artc-asr/artc_ranger_xarm6/ranger_xarm6_description/meshes/big_plant.stl

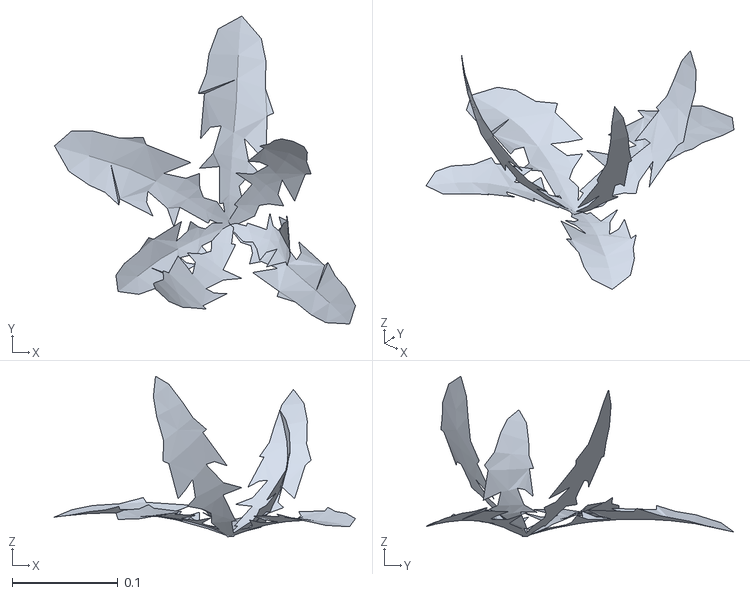
[picture p8: CAD file, 2026-09-24]
ranger_xarm6_description/meshes/big_plant.stl
0.285 x 0.291 x 0.152
