artc-asr/artc_ranger_xarm6/ranger_xarm6_description/meshes/collision/extras_compressed/extras_compressed_48.stl

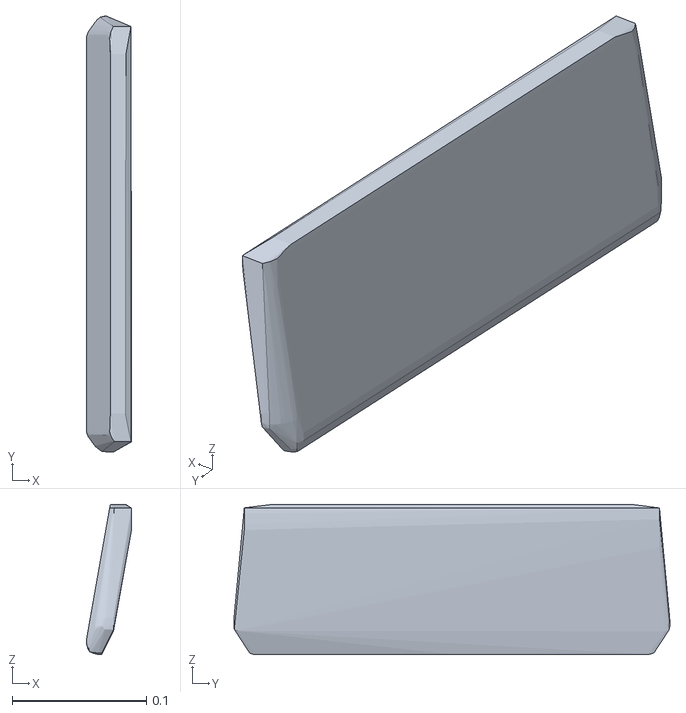
[picture p9: CAD file, 2026-09-24]
ranger_xarm6_description/meshes/collision/extras_compressed/extras_compressed_48.stl
0.0338 x 0.324 x 0.112
