artc-asr/artc_ranger_xarm6/ranger_xarm6_description/meshes/collision/hipnuc_imu/hipnuc_imu_07.stl

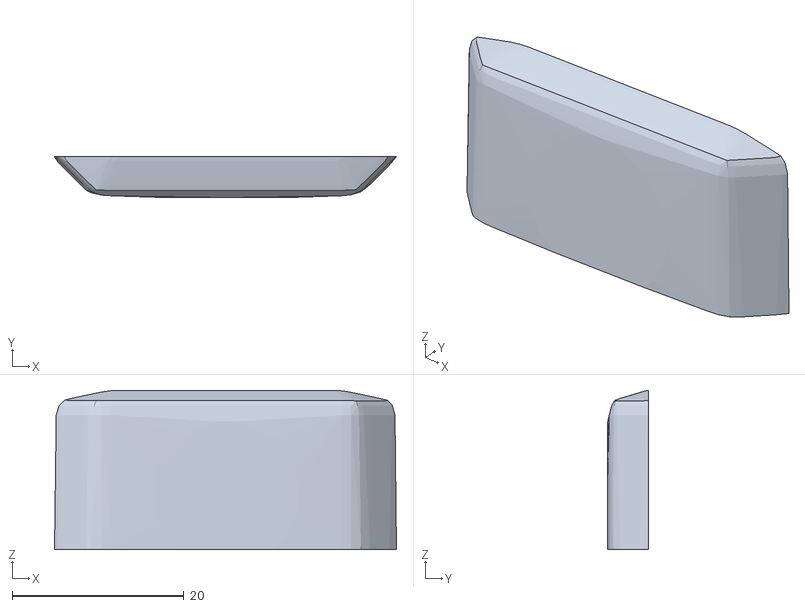
[picture p10: CAD file, 2026-09-24]
ranger_xarm6_description/meshes/collision/hipnuc_imu/hipnuc_imu_07.stl
39.9 x 4.73 x 18.6
