artc-asr/artc_ranger_xarm6/ranger_xarm6_description/meshes/collision/livox_imu_mount/livox_imu_mount_03.stl

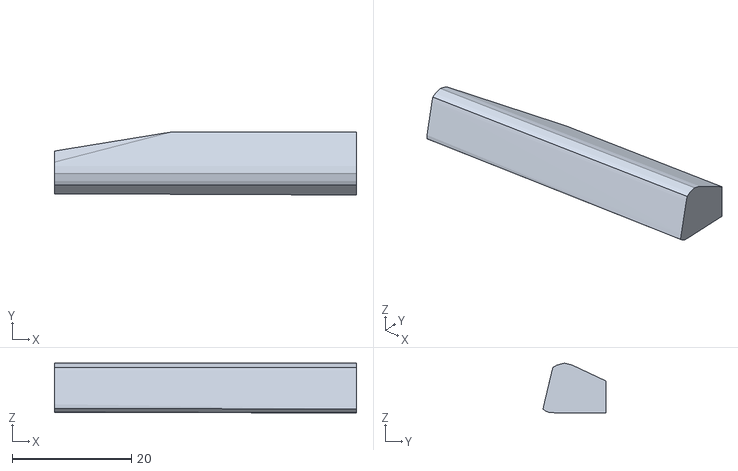
[picture p11: CAD file, 2026-09-24]
ranger_xarm6_description/meshes/collision/livox_imu_mount/livox_imu_mount_03.stl
50.7 x 10.6 x 8.35
