artc-asr/artc_ranger_xarm6/ranger_xarm6_description/meshes/collision/livox_mid_360/livox_mid_360_03.stl

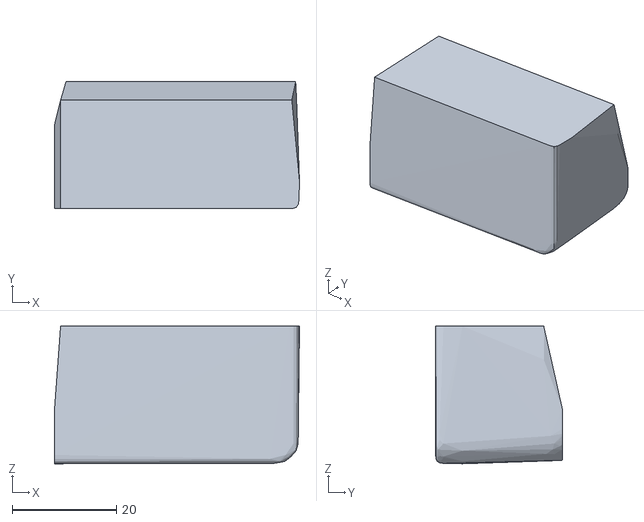
[picture p12: CAD file, 2026-09-24]
ranger_xarm6_description/meshes/collision/livox_mid_360/livox_mid_360_03.stl
47.0 x 24.3 x 26.4
