artc-asr/artc_ranger_xarm6/ranger_xarm6_description/meshes/collision/xarm_mount_plate/xarm_mount_plate_02.stl

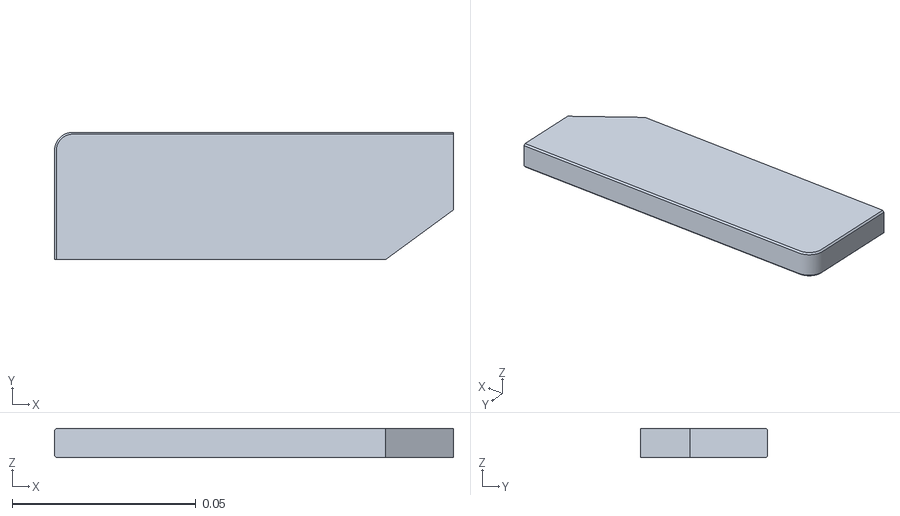
[picture p13: CAD file, 2026-09-24]
ranger_xarm6_description/meshes/collision/xarm_mount_plate/xarm_mount_plate_02.stl
0.109 x 0.0347 x 0.008
