artc-asr/artc_ranger_xarm6/ranger_xarm6_description/meshes/collision/extras_compressed/extras_compressed_25.stl

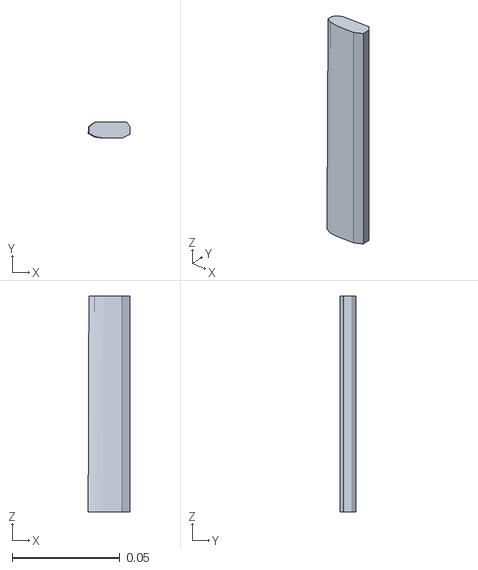
[picture p15: CAD file, 2026-09-24]
ranger_xarm6_description/meshes/collision/extras_compressed/extras_compressed_25.stl
0.0194 x 0.00761 x 0.1
