artc-asr/artc_ranger_xarm6/ranger_xarm6_description/meshes/collision/hipnuc_imu/hipnuc_imu_06.stl

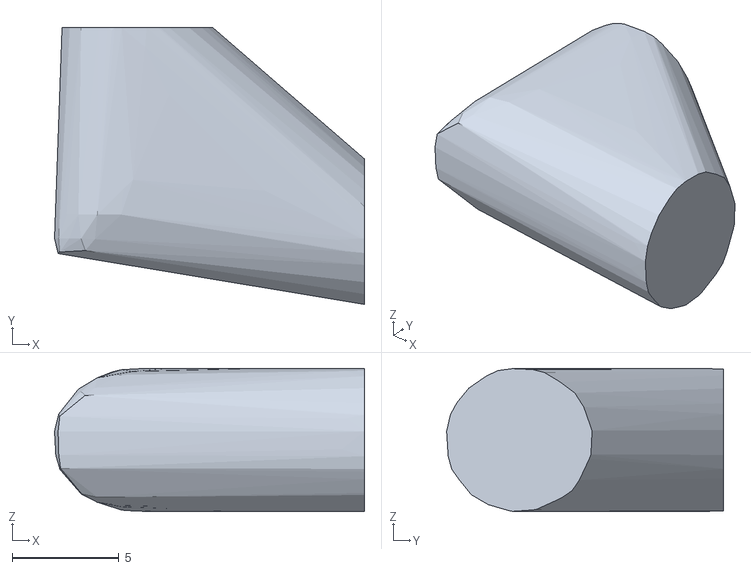
[picture p16: CAD file, 2026-09-24]
ranger_xarm6_description/meshes/collision/hipnuc_imu/hipnuc_imu_06.stl
14.5 x 13.0 x 6.72
