artc-asr/artc_ranger_xarm6/ranger_xarm6_description/meshes/collision/livox_imu_mount/livox_imu_mount_07.stl

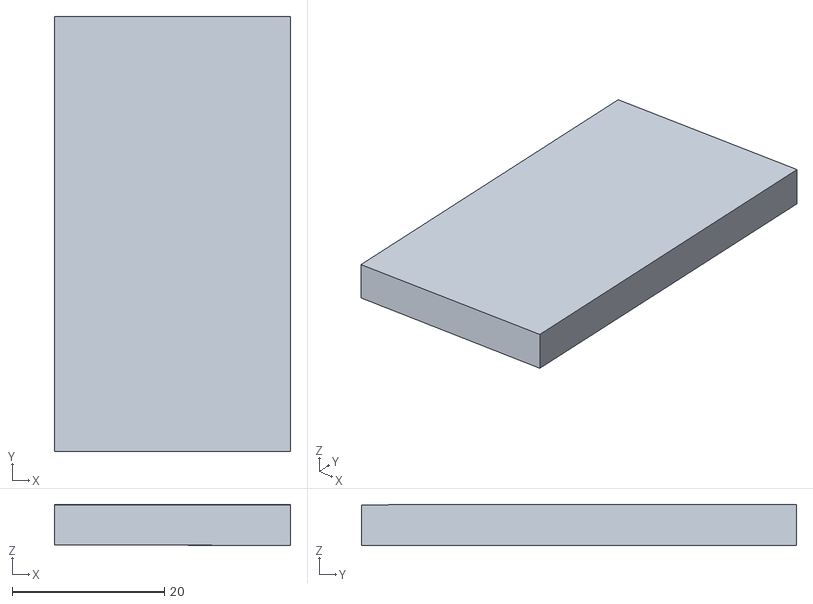
[picture p17: CAD file, 2026-09-24]
ranger_xarm6_description/meshes/collision/livox_imu_mount/livox_imu_mount_07.stl
31.1 x 57.2 x 5.41
