artc-asr/artc_ranger_xarm6/ranger_xarm6_description/meshes/collision/livox_mid_360/livox_mid_360_07.stl

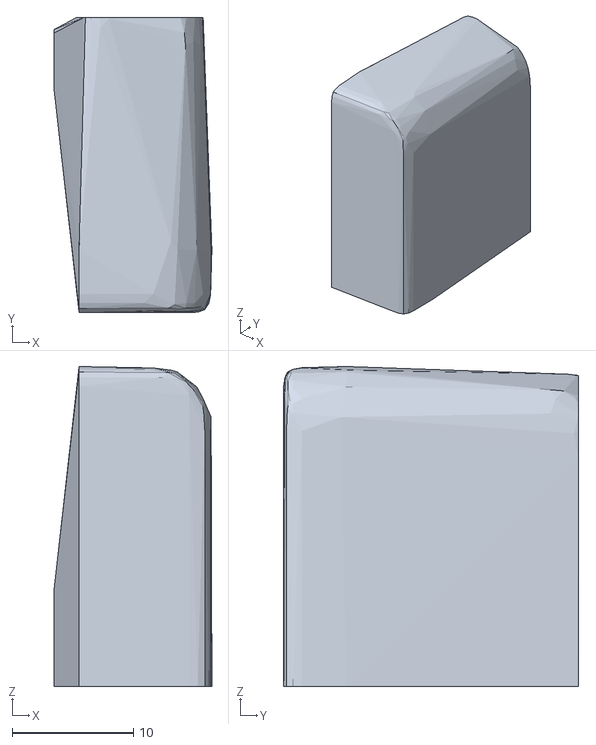
[picture p18: CAD file, 2026-09-24]
ranger_xarm6_description/meshes/collision/livox_mid_360/livox_mid_360_07.stl
13.0 x 24.3 x 26.4
