artc-asr/artc_ranger_xarm6/ranger_xarm6_description/meshes/collision/xarm_mount_plate/xarm_mount_plate_06.stl

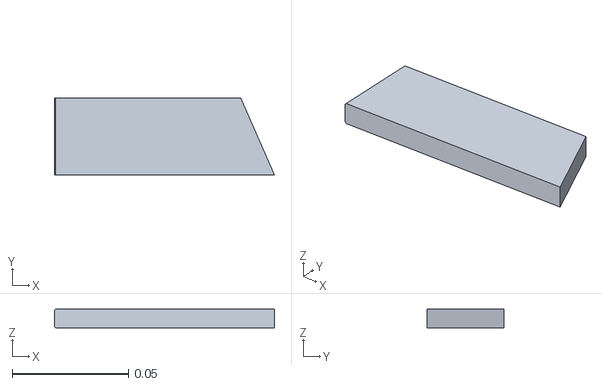
[picture p19: CAD file, 2026-09-24]
ranger_xarm6_description/meshes/collision/xarm_mount_plate/xarm_mount_plate_06.stl
0.0945 x 0.0331 x 0.008
