artc-asr/artc_ranger_xarm6/ranger_xarm6_description/meshes/livox_imu_mount.stl

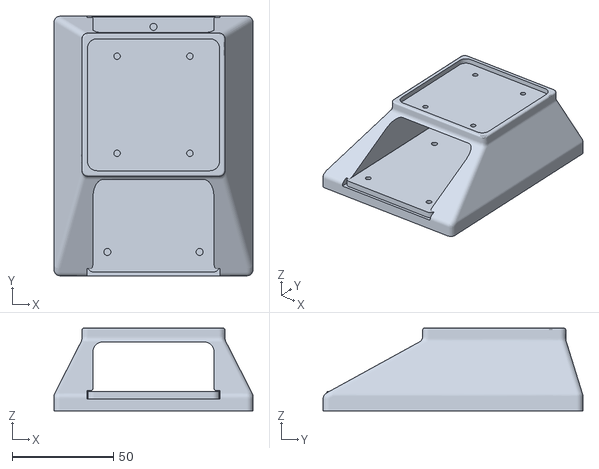
[picture p20: CAD file, 2026-09-24]
ranger_xarm6_description/meshes/livox_imu_mount.stl
98.4 x 128.4 x 41.0
