artc-asr/artc_ranger_xarm6/ranger_xarm6_description/meshes/collision/extras_compressed/extras_compressed_32.stl

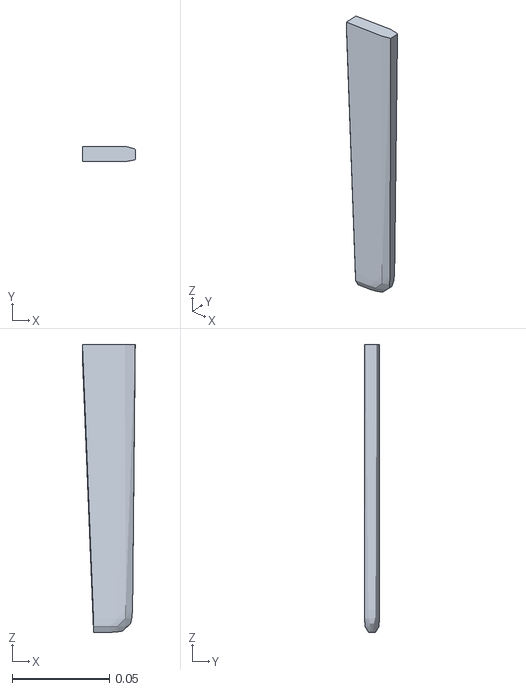
[picture p21: CAD file, 2026-09-24]
ranger_xarm6_description/meshes/collision/extras_compressed/extras_compressed_32.stl
0.0271 x 0.00794 x 0.148
