artc-asr/artc_ranger_xarm6/ranger_xarm6_description/meshes/collision/hipnuc_imu/hipnuc_imu_08.stl

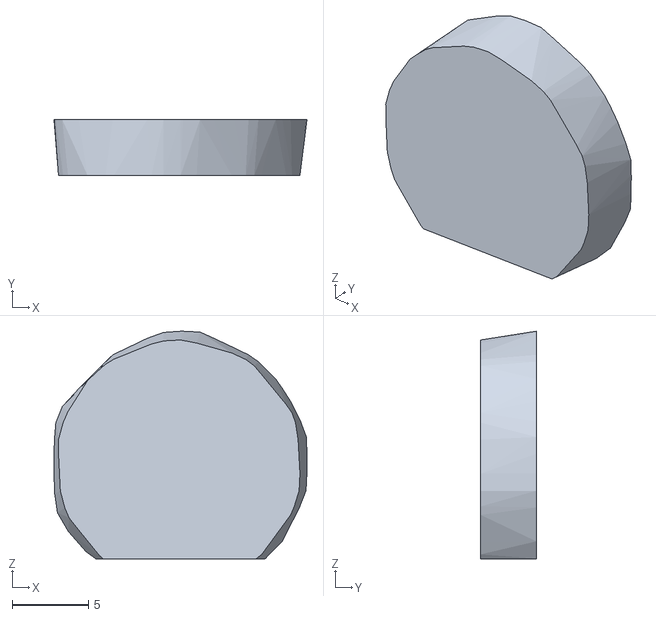
[picture p22: CAD file, 2026-09-24]
ranger_xarm6_description/meshes/collision/hipnuc_imu/hipnuc_imu_08.stl
16.6 x 3.66 x 15.0
