artc-asr/artc_ranger_xarm6/ranger_xarm6_description/meshes/collision/livox_imu_mount/livox_imu_mount_09.stl

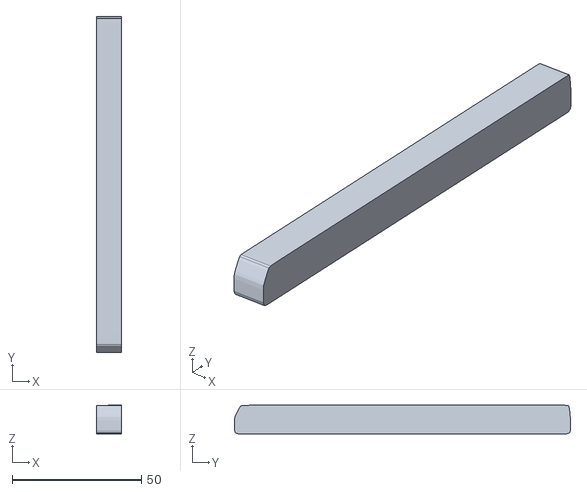
[picture p23: CAD file, 2026-09-24]
ranger_xarm6_description/meshes/collision/livox_imu_mount/livox_imu_mount_09.stl
9.68 x 129.8 x 11.1
