artc-asr/artc_ranger_xarm6/ranger_xarm6_description/meshes/collision/livox_mid_360/livox_mid_360_01.stl

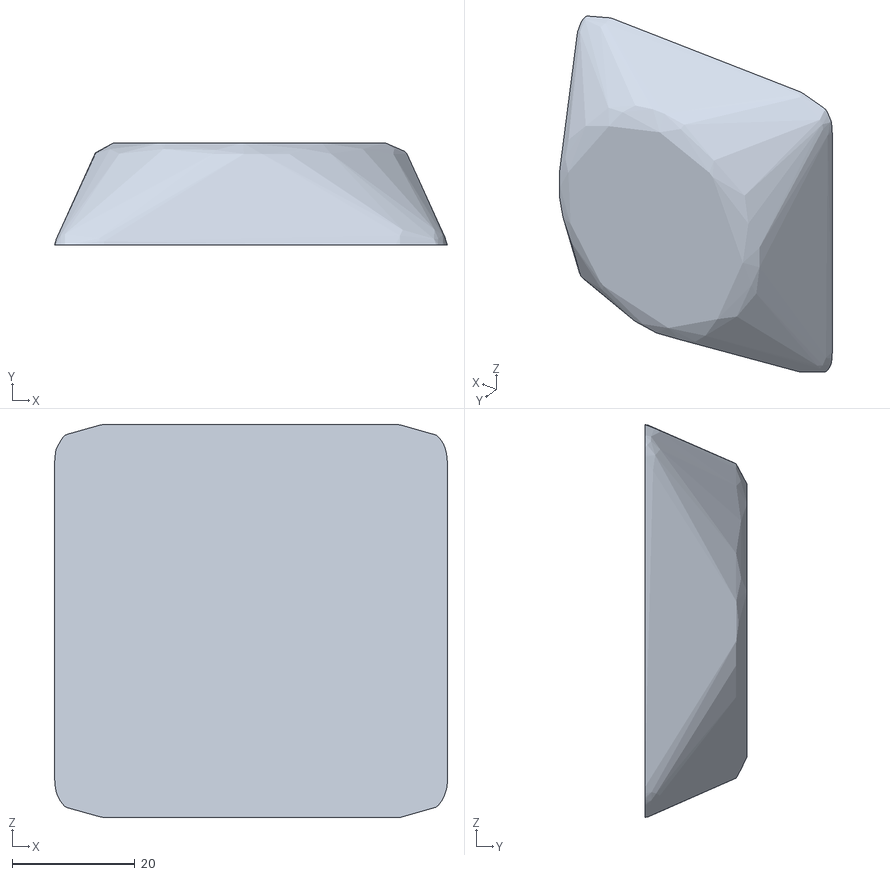
[picture p24: CAD file, 2026-09-24]
ranger_xarm6_description/meshes/collision/livox_mid_360/livox_mid_360_01.stl
64.1 x 16.7 x 64.2
