artc-asr/artc_ranger_xarm6/ranger_xarm6_description/meshes/collision/xarm_mount_plate/xarm_mount_plate_04.stl

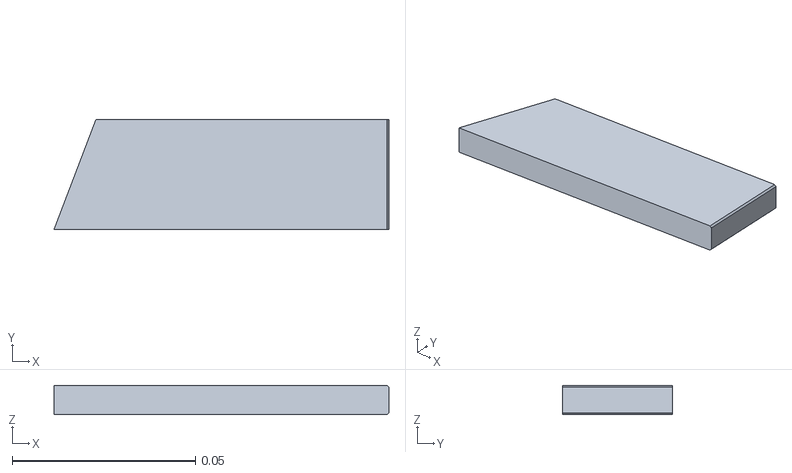
[picture p25: CAD file, 2026-09-24]
ranger_xarm6_description/meshes/collision/xarm_mount_plate/xarm_mount_plate_04.stl
0.0914 x 0.03 x 0.008
