artc-asr/artc_ranger_xarm6/ranger_xarm6_description/meshes/hipnuc_imu.stl

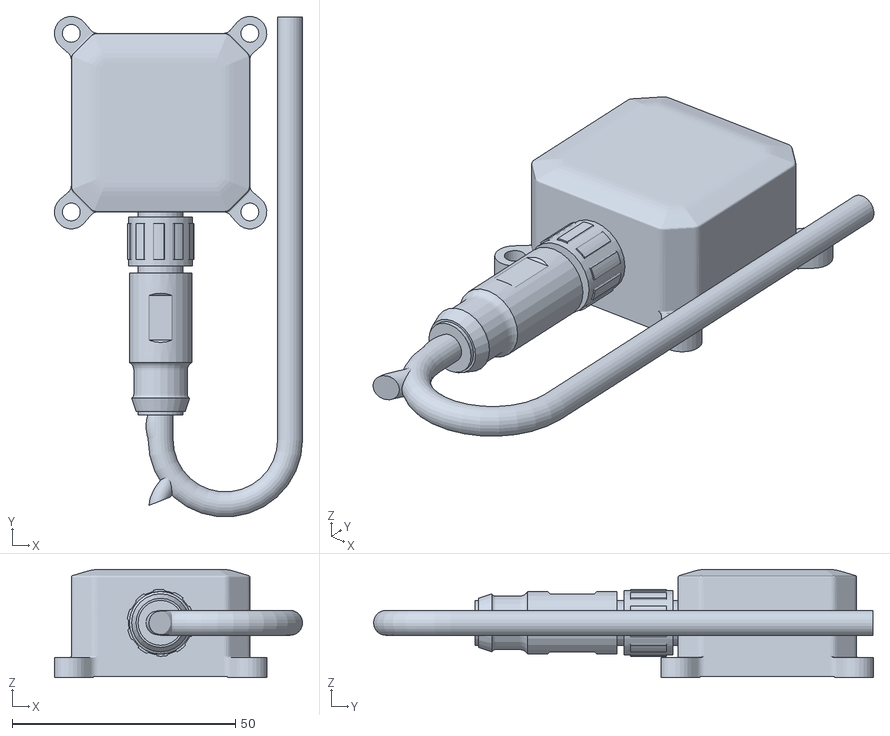
[picture p26: CAD file, 2026-09-24]
ranger_xarm6_description/meshes/hipnuc_imu.stl
55.6 x 112.0 x 24.3
