artc-asr/artc_ranger_xarm6/ranger_xarm6_description/meshes/collision/extras_compressed/extras_compressed_26.stl

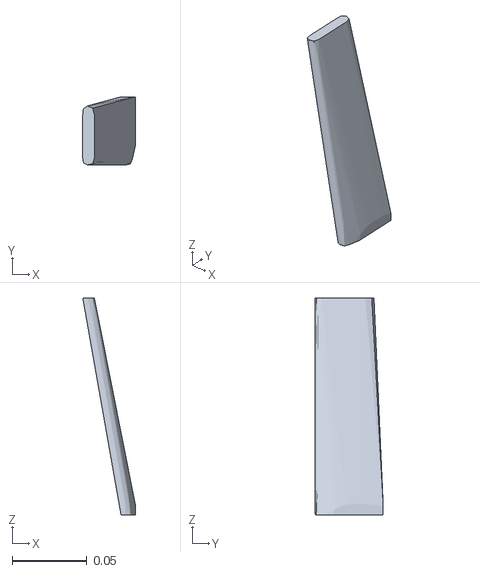
[picture p27: CAD file, 2026-09-24]
ranger_xarm6_description/meshes/collision/extras_compressed/extras_compressed_26.stl
0.035 x 0.0457 x 0.145
