artc-asr/artc_ranger_xarm6/ranger_xarm6_description/meshes/collision/hipnuc_imu/hipnuc_imu_10.stl

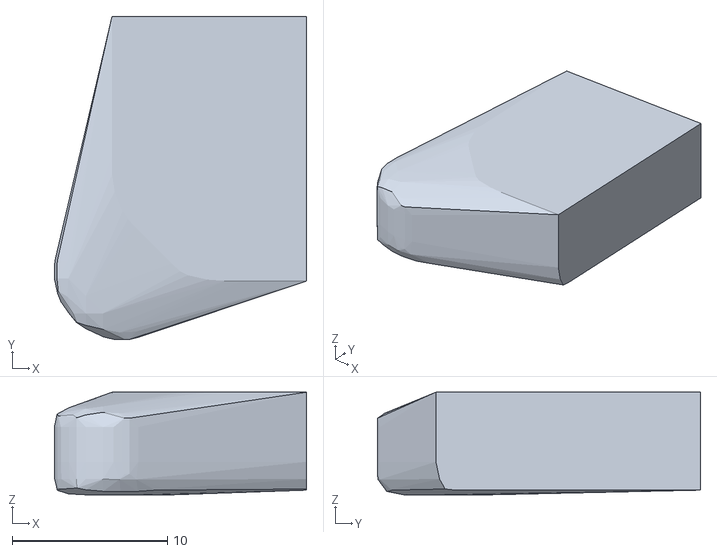
[picture p28: CAD file, 2026-09-24]
ranger_xarm6_description/meshes/collision/hipnuc_imu/hipnuc_imu_10.stl
16.3 x 20.8 x 6.61
