artc-asr/artc_ranger_xarm6/ranger_xarm6_description/meshes/collision/livox_imu_mount/livox_imu_mount_12.stl

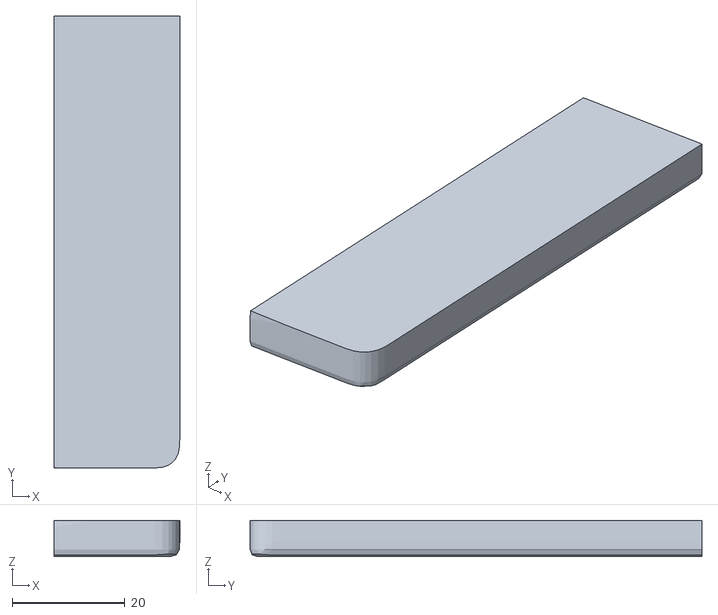
[picture p29: CAD file, 2026-09-24]
ranger_xarm6_description/meshes/collision/livox_imu_mount/livox_imu_mount_12.stl
22.3 x 80.3 x 6.45
