artc-asr/artc_ranger_xarm6/ranger_xarm6_description/meshes/collision/livox_mid_360/livox_mid_360_05.stl

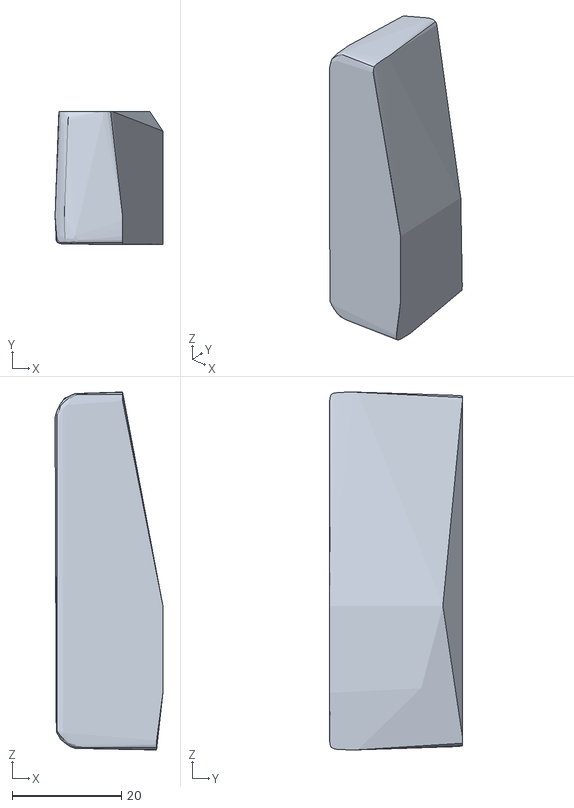
[picture p30: CAD file, 2026-09-24]
ranger_xarm6_description/meshes/collision/livox_mid_360/livox_mid_360_05.stl
19.8 x 24.3 x 65.6
