artc-asr/artc_ranger_xarm6/ranger_xarm6_description/meshes/collision/xarm_mount_plate/xarm_mount_plate_07.stl

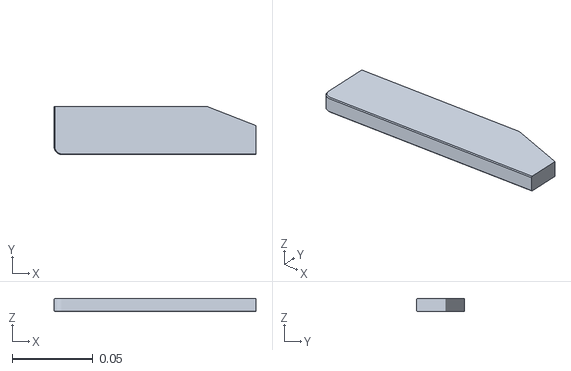
[picture p31: CAD file, 2026-09-24]
ranger_xarm6_description/meshes/collision/xarm_mount_plate/xarm_mount_plate_07.stl
0.125 x 0.0299 x 0.008
