artc-asr/artc_ranger_xarm6/ranger_xarm6_description/meshes/ft_sensor_ai1302.stl

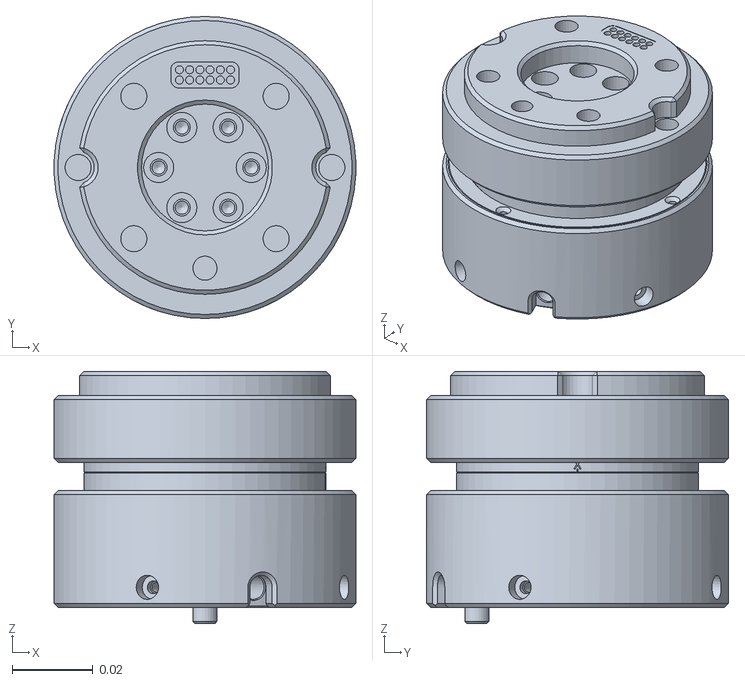
[picture p32: CAD file, 2026-09-24]
ranger_xarm6_description/meshes/ft_sensor_ai1302.stl
0.0749 x 0.075 x 0.0626
