artc-asr/artc_ranger_xarm6/ranger_xarm6_description/meshes/collision/extras_compressed/extras_compressed_05.stl

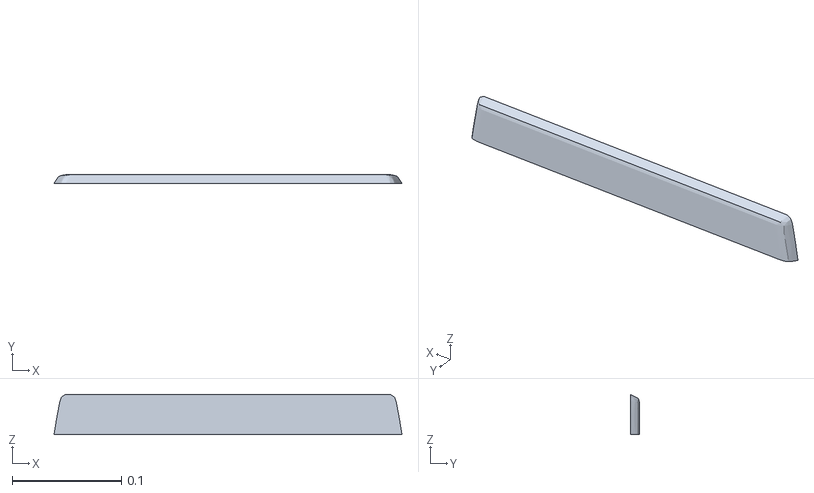
[picture p33: CAD file, 2026-09-24]
ranger_xarm6_description/meshes/collision/extras_compressed/extras_compressed_05.stl
0.319 x 0.00799 x 0.0368
