artc-asr/artc_ranger_xarm6/ranger_xarm6_description/meshes/collision/hipnuc_imu/hipnuc_imu_00.stl

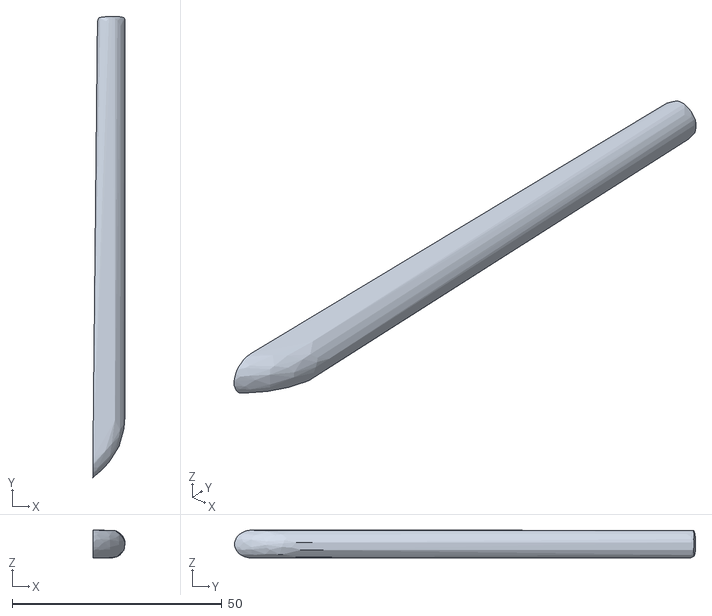
[picture p34: CAD file, 2026-09-24]
ranger_xarm6_description/meshes/collision/hipnuc_imu/hipnuc_imu_00.stl
7.70 x 109.9 x 6.65
