artc-asr/artc_ranger_xarm6/ranger_xarm6_description/meshes/collision/livox_imu_mount/livox_imu_mount_04.stl

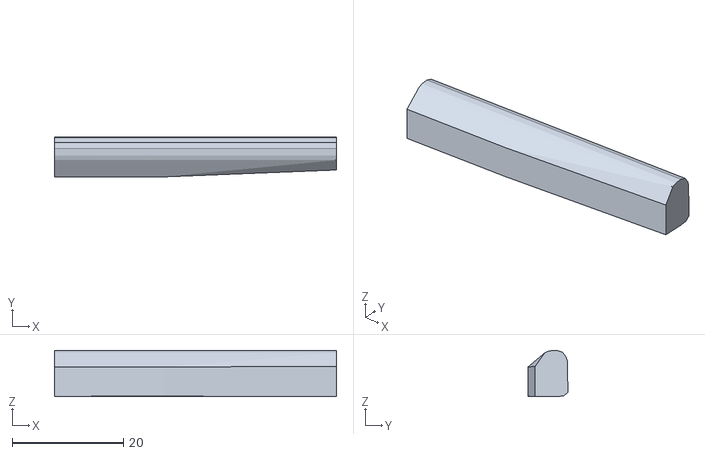
[picture p35: CAD file, 2026-09-24]
ranger_xarm6_description/meshes/collision/livox_imu_mount/livox_imu_mount_04.stl
50.7 x 7.17 x 8.34
