artc-asr/artc_ranger_xarm6/ranger_xarm6_description/meshes/collision/xarm_mount_plate/xarm_mount_plate_03.stl

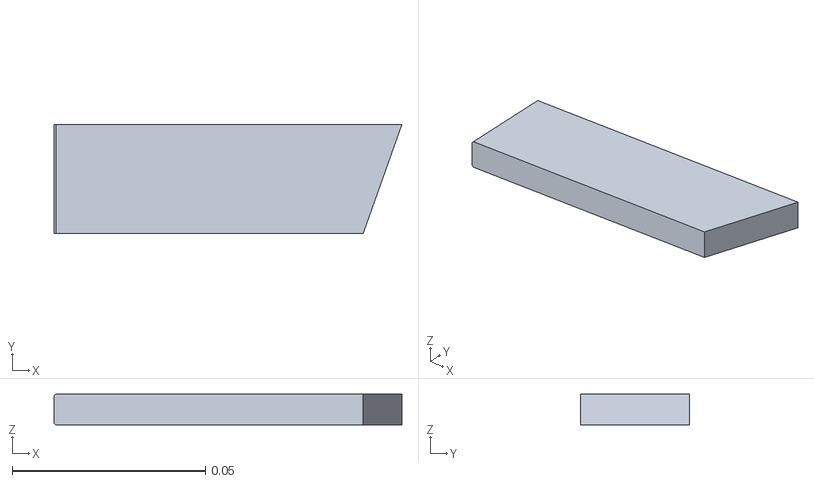
[picture p37: CAD file, 2026-09-24]
ranger_xarm6_description/meshes/collision/xarm_mount_plate/xarm_mount_plate_03.stl
0.09 x 0.0283 x 0.008
