artc-asr/artc_ranger_xarm6/ranger_xarm6_description/meshes/ft_sensor_ai1302_collision.stl

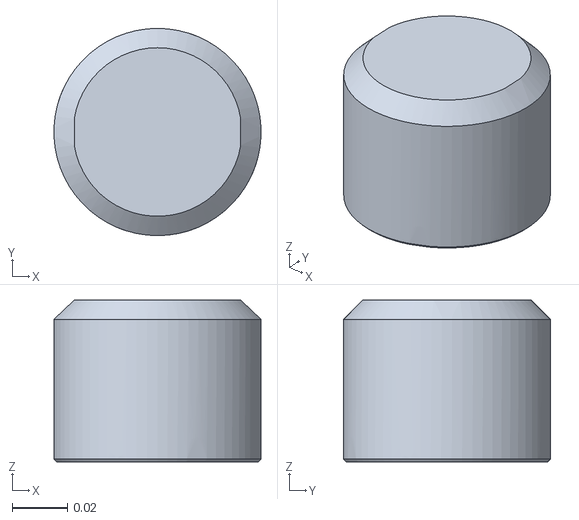
[picture p38: CAD file, 2026-09-24]
ranger_xarm6_description/meshes/ft_sensor_ai1302_collision.stl
0.0749 x 0.075 x 0.0586
