artc-asr/artc_ranger_xarm6/ranger_xarm6_description/meshes/livox_mid_360.stl

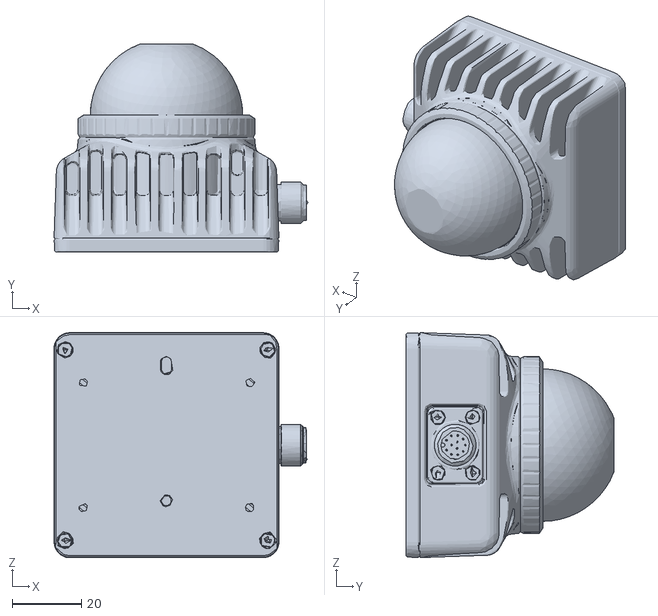
[picture p44: CAD file, 2026-09-23]
ranger_xarm6_description/meshes/livox_mid_360.stl
73.2 x 60.1 x 65.0
