artc-asr/artc_ranger_xarm6/ranger_xarm6_description/meshes/extras_compressed.stl

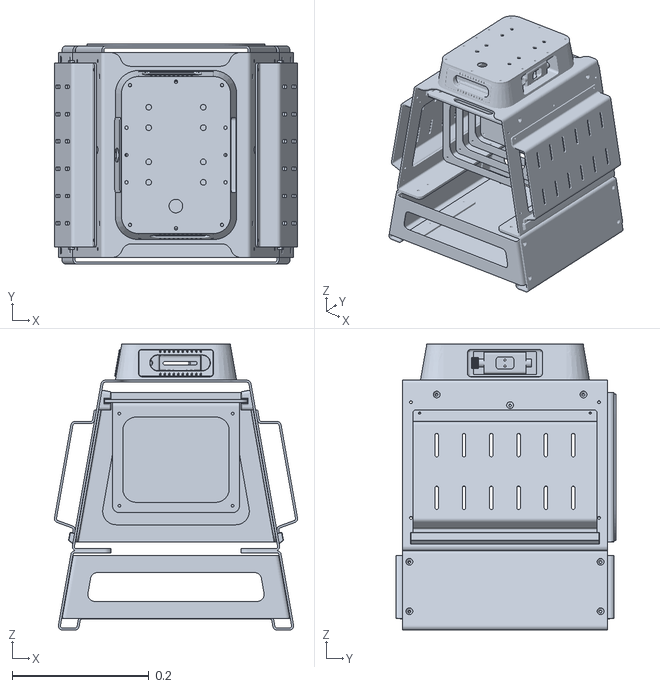
[picture p50: CAD file, 2026-09-22]
ranger_xarm6_description/meshes/extras_compressed.stl
0.356 x 0.323 x 0.419
