artc-asr/artc_ranger_xarm6/ranger_xarm6_description/meshes/xarm_mount_plate.stl

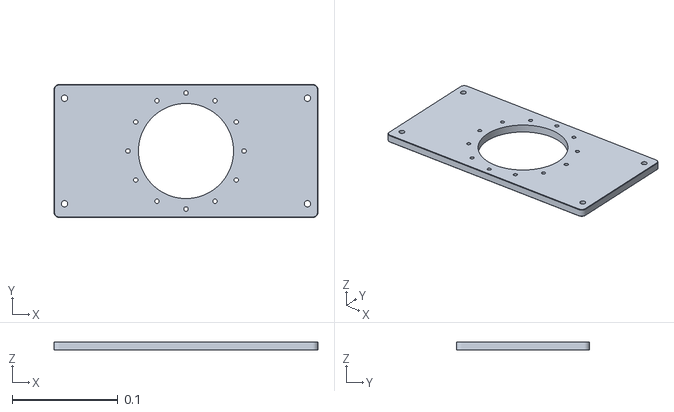
[picture p56: CAD file, 2026-09-22]
ranger_xarm6_description/meshes/xarm_mount_plate.stl
0.25 x 0.126 x 0.008
