artc-asr/artc_ranger_xarm6/ranger_xarm6_manipulation/config/base_trajectory_server.yaml

# base_trajectory_server.py tuning. Speeds along a plan come from
# MoveIt's time parameterization (ranger_xarm6_moveit_config's
# joint_limits.yaml); these only clamp the tracking commands. The Ranger
# Mini 3 driver itself clamps to 2.7 m/s and 0.785 rad/s spinning
# (westonrobot_ranger_ros2 RangerMiniV2Params, used for V3).
# odom_frame/base_frame are set by launch/control.launch.py.
/**:
  ros__parameters:
    max_linear_speed: 1.0        # m/s; plans reach 1.41 diagonally at scaling 1.0
    max_angular_speed: 0.78      # rad/s
    kp_linear: 1.5               # 1/s, position correction
    kp_angular: 2.0              # 1/s
    xy_tolerance: 0.02           # m, at the end
    yaw_tolerance: 0.02          # rad, at the end
    path_xy_tolerance: 0.3       # m off the plan while tracking -> abort
    path_yaw_tolerance: 0.3      # rad
    goal_time_tolerance: 3.0     # s after the plan's end to reach tolerance
    mode_switch_pause: 0.5       # s stopped after each trajectory (wheel re-steer)
    still_xy: 0.005              # m in total: below = not translating
    still_yaw: 0.01              # rad in total: below = not rotating
    control_rate: 20.0           # Hz
    # auto: through ranger_xarm6_navigation's collision_monitor while it
    # runs (it listens on cmd_vel_smoothed), else straight to cmd_vel.
    # always | never. See base_trajectory_server.py.
    collision_monitor: auto
