artc-asr/artc_ranger_xarm6/ranger_xarm6_moveit_config/config/ompl_planning.yaml

# OMPL planner configs per planning group (loaded under the 'ompl' planning
# pipeline namespace by launch/move_group.launch.py).
planner_configs:
  RRTConnectkConfigDefault:
    type: geometric::RRTConnect
    range: 0.0
  RRTstarkConfigDefault:
    type: geometric::RRTstar
    range: 0.0
    goal_bias: 0.05
    delay_collision_checking: 1
  PRMstarkConfigDefault:
    type: geometric::PRMstar
  BiTRRTkConfigDefault:
    type: geometric::BiTRRT
    range: 0.0
    temp_change_factor: 0.1
    init_temperature: 100
    frontier_threshold: 0.0
    frontier_node_ratio: 0.1
    cost_threshold: 1e300

arm:
  default_planner_config: RRTConnectkConfigDefault
  planner_configs: [RRTConnectkConfigDefault, RRTstarkConfigDefault, PRMstarkConfigDefault, BiTRRTkConfigDefault]
  # Collision-check spacing along the path, as a fraction of the joint
  # space's extent (large here: joint1/4/6 turn +-2pi). 0.005 let a path
  # through the Livox slip between checks.
  longest_valid_segment_fraction: 0.002

gripper:
  default_planner_config: RRTConnectkConfigDefault
  planner_configs: [RRTConnectkConfigDefault]

# Base groups (urdf/ranger_xarm6_moveit.urdf.xacro). longest_valid_segment_fraction
# is a fraction of the group's joint-space extent, which the base's
# +-base_workspace x/y range dominates: 0.0002 is ~1.6cm of base travel
# at the default 20m, ~2.6cm (summed over all joints) for whole_body.
base_translation:
  default_planner_config: RRTConnectkConfigDefault
  planner_configs: [RRTConnectkConfigDefault, RRTstarkConfigDefault]
  longest_valid_segment_fraction: 0.0002

base_rotation:
  default_planner_config: RRTConnectkConfigDefault
  planner_configs: [RRTConnectkConfigDefault]
  # One continuous joint (extent pi): ~0.6 deg between checks.
  longest_valid_segment_fraction: 0.003

whole_body:
  default_planner_config: RRTConnectkConfigDefault
  planner_configs: [RRTConnectkConfigDefault, RRTstarkConfigDefault, BiTRRTkConfigDefault]
  longest_valid_segment_fraction: 0.0002
