artc-asr/artc_ranger_xarm6/(commit log)

2026-09-18 Replace Robotnik/UR5e workspace with Ranger Mini 3.0 + xArm6
    Removes the Theron/Kairos (Robotnik + UR5e) packages and adds the
    Ranger Mini 3.0 + xArm6 mobile manipulator: description/bringup
    (ranger_xarm6_description), vendored xarm_ros2 and
    westonrobot_ranger_ros2, and the agilex base description (fetched via
    agilex_description.jazzy.repos, gitignored).
    wbcc_controller/wbc.py and wbc_visualize.py gain a RANGER_MINI
    RobotType alongside Theron/Kairos. Ranger-specific work in this
    commit:
    - "Initial Position" button now works for Ranger: teleports the base
    to the same in-front-of-wall pose Theron/Kairos use, then P-controls
    arm_velocity_controller to an IK-solved ready pose (Ranger has no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
    [ranger_xarm6.urdf.xacro, ros2_controllers.yaml]
2026-09-18 Fix Ranger's green path display, wall standoff, and missing wheels
    Found via actual RViz/Gazebo inspection (not caught by the previous
    commit's topic-level-only testing):
    - ranger_xarm6.rviz had no Path display for path_topic at all; even
    after adding one, it rendered nothing until Buffer Length: 1 was set
    (confirmed missing by diffing against the old Robotnik rviz config,
    which has it) -- the property tf2_ros/rviz needs to actually draw a
    received nav_msgs/Path, not just accept the message.
    - Ranger's Initial Position EE standoff from the wall was ~0.25m
    (x=2.60), further than Theron/Kairos's own ready poses look. Reduced
    to ~0.05m (x=2.80, matching path.yaml's own waypoint x)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
    [ranger_xarm6.urdf.xacro]
2026-09-18 Reach the path's actual start point; fix a base-height bug in wbc.py
    Ranger's Initial Position EE was reaching only z=0.95, well short of
    the wall path's actual first waypoint (path.yaml: [2.80, 4.9, 1.3]).
    At the original 0.05m arm_base_joint mount, z=1.3 isn't reachable at
    any base standoff, including the chassis touching the wall -- so this
    moves the base closer (RANGER_INIT_BASE_X 2.35 -> 2.5, chassis still
    clears the wall by ~0.10m) and raises the mount to 0.3m (both
    ranger_xarm6.urdf.xacro and urdf/ranger_xarm6.urdf).
    Re-deriving the IK caught a methodology bug in the previous commit's
    numbers (init_joint_positions there landed at world z=1.40, not 1.30,
    confirmed against live TF -- a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
    [ranger_xarm6.urdf.xacro]
2026-09-18 Wire up Ranger base driving in simulation (kinematic, not physics)
    Ranger's wheels have no ros2_control command interface and no real
    drive plugin (by design, real hardware drive is separate follow-up
    work), so wbc.py's cmd_vel has never gone anywhere and the base has
    never moved in sim -- flagged as the dominant reason whole-body path
    tracking failed in the previous commit's controller review.
    base_pose_publisher.py (previously just the sole odom->base_link TF
    owner for the "Initial Position" button's teleport) now also drives
    the base: subscribes to cmd_vel, integrates the body-frame twist
    (vx, vy, omega -- the same convention wbc.py already restricts to a
    mode Ranger's real swerve base c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
    [ranger_xarm6.urdf.xacro]
2026-09-18 Add safety clamp to base driver; document full-path tracking failure
    Tested whether wbc.py can actually track the whole path (not just the
    first stretch) now that base driving is wired up. It can't, and
    reproduced why -- two distinct problems:
    1. Once MOVING_WITH_FORCE needs more Y-range than the arm can cover
    from a stationary base, the whole-body QP can apparently command
    enough +X (toward-wall) base motion to walk the base into the wall.
    base_pose_publisher.py's teleport has zero collision awareness (it's
    kinematic, not physics), so it obediently did it: the base ended up
    teleported to x=3.045, inside the wall's collision box (x=2.85..3.15).
    Once embedded, Gazebo's stif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
2026-09-20 Fix three real bugs blocking Ranger+xArm6 tracking; remove Theron/Kairos support
    Three confirmed bugs fixed in wbc.py, found while debugging why FDCC lost
    contact and drifted over time on Ranger+xArm6 (none of these are tuning
    issues):
    1. Base wall-standoff cost regulated the wrong DOF. Ranger spawns at
    yaw=-pi/2 (sideways to the wall, unlike Theron/Kairos), which flips
    which virtual base joint maps to which world axis. Verified
    numerically (perturb each base joint, read the FK delta): q[1] ("v_x")
    moves world -Y (sweep axis), q[2] ("v_y") moves world +X (the actual
    wall-approach axis). The standoff cost was on c[1]; moved to c[2].
    2. joint_velocity_damper() called with posi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
    [ranger_xarm6.urdf.xacro]
2026-09-21 Port feat/xarm6-agilex to Humble: vendor missing ranger_mini_v3_description, fix rosdep gaps
    Adapts feat/xarm6-agilex-jazzy for ROS 2 Humble / Ubuntu 22.04 + Gazebo
    Harmonic, following the same approach as feat/ur5-robotnik-humble.
    - Vendor ranger_mini_v3_description: this package was never vendored on
    the jazzy branch at all (no submodule, no source, not even a broken
    gitlink) despite ranger_xarm6.urdf.xacro requiring
    $(find ranger_mini_v3_description)/urdf/ranger_mini_v3.xacro and
    xacro:ranger_mini_v3 prefix="...". Sourced from the pinned commits'
    own upstream docs (Weston Robot's docs.westonrobot.com links, confirmed
    against the ARTC Ranger Mini3 handover note) to AgileX's of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
    [ranger_mini_v3.xacro]
2026-09-21 Fix base_pose_publisher's entity-spawn race (Gazebo console error spam)
    base_pose_publisher.py's _gz_set_pose() called gz_node.request(...) and
    discarded the (result, response) return entirely. On startup, this node's
    initial teleport call and its 30Hz teleport thread both start immediately,
    racing the separate ros_gz_sim 'create' node that's still spawning the
    entity -- every set_pose call in that ~1-2s window gets rejected
    server-side, and since the rejection is a normal (non-exception) response
    with data=false, not a communication failure, the node never noticed.
    Gazebo's own C++ UserCommands plugin logs the rejection independently on
    its own console regardless of what the client does wit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
2026-09-22 Correct base->arm mount FT via Gazebo visual inspection
    The STEP-file-derived mount transform (arm_mount_xyz/arm_mount_rpy in
    ranger_xarm6.urdf.xacro, mirrored in urdf/ranger_xarm6.urdf) placed the
    arm too high and at the wrong yaw once actually viewed in Gazebo.
    Root cause: the mounting-plate height (0.25368m) was measured relative
    to the STEP CAD's "Ranger Mini 3.0" node origin, which is not the same
    reference point as this package's base_link (base_link sits near the
    top of the chassis per ranger_mini_v3.xacro's collision box/visual
    mesh, while the STEP node's origin is deeper inside the body). x
    (-0.2185) checked out visually and is unaffected.
    Corrected z to 0.024m and yaw to 180 degr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
    [ranger_xarm6.urdf.xacro]
2026-09-22 Add xarm_ros2, ugv_sdk, westonrobot_ranger_ros2 as submodules
    Pinned to the same commits currently checked out in wbcc_mm so the
    description packages build identically.
2026-09-22 Add mount plate, tool head, and camera rig meshes from STEP CAD; fix Gazebo Harmonic gz_ros2_control plugin ABI mismatch
    Extracts and adds three parts from RM_Version_1.2_production.step that
    were missing from the Gazebo model:
    - mount_plate_link: the arm-to-base bracket, precisely positioned via
    STEP-verified assembly mating, fixed to base_link.
    - extras_link: camera rig (USB/RealSense modules, top plate) plus
    leftover STEP hardware, merged into one mesh via CadQuery (FreeCAD's
    own STEP tessellation was silently dropping faces at part seams,
    visible as a disconnected/"floating" panel; CadQuery and
    pythonocc-core don't have this issue), fixed to base_link.
    - tool_head_link: wrist e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
    [extras_compressed.stl, ranger_xarm6.urdf.xacro, tool_head.stl, xarm_mount_plate.stl]
2026-09-22 Add UFACTORY F/T sensor variant and G2 gripper; remove superseded tool_head_link
    model1300="true" on the xarm_device call swaps link6's mesh to
    xarm_description's end_tool_1300 model (the F/T-sensor-equipped tool
    flange) -- confirmed as the correct hardware variant by
    RM_Version_1.2_production.step's own arm node name, "xArm6(XI1300)_...".
    add_gripper/gripper_version="G2" adds the real UFACTORY G2 gripper at
    link_eef: full kinematic tree (base_link, knuckles, fingers, mimic
    joints), its own ros2_control resource, and a
    gripper_position_controller (config/ros2_controllers.yaml + launch
    spawner) so it's commandable in Gazebo immediately, matching how the
    arm itself is wired.
    Removes tool_hea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
    [ranger_xarm6.urdf.xacro, ros2_controllers.yaml, tool_head.stl]
2026-09-22 Add wrist-mounted RealSense D435i camera; fix duplicate Sensors plugin crash
    add_realsense_d435i="true" adds the D435i camera+stand at link_eef with
    the Harmonic-native realsense_gz sensor plugin (rgbd_camera + color/IR
    cameras). Physical stack, per instruction: link6 (F/T sensor, already
    in the end_tool_1300 mesh) -> camera -> gripper, in series.
    The G2 gripper is now attached explicitly in this file instead of via
    xarm_device's own add_gripper, offset 0.03m (the camera+stand's
    measured depth) past link_eef so it doesn't overlap the camera body;
    xarm_device_macro.xacro hardcodes the gripper's attach offset at zero
    with no parameter to override it, so this avoids editing the vendored
    xarm_r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
    [ranger_xarm6.urdf.xacro]
2026-09-22 Tune gripper attach offset from 30mm to 3mm per visual check in Gazebo
    The 30mm estimate (camera+stand mesh's own bounding-box depth) put the
    gripper too far out; corrected visually to 3mm, same provisional
    workflow as arm_mount_xyz/rpy and mount_plate_xyz/rpy before it.
    [ranger_xarm6.urdf.xacro]
2026-09-22 Add two frame-mounted RealSense D435i cameras (fixed_cam1/fixed_cam2)
    Per RM_Version_1.2_production.step's "Camera_module_for_design" cluster:
    "Realsense_Camera_module v2" and "Realsense_Camera_module
    v1(Mirror)(Mirror)" sit at the exact same point (0.0mm position
    difference) differing only by a 180deg rotation about one axis, i.e.
    these are two real cameras mounted back-to-back at the same point
    facing opposite directions, not unresolved design variants of one
    camera like the rest of that cluster (already folded into extras_link)
    turned out to be. Final intended hardware is 3 cameras total: these 2
    D435i plus 1 Orbbec Gemini 2 on the wrist (replacing the arm's current
    D435i eventually, soft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
    [ranger_xarm6.urdf.xacro]
2026-09-22 Swap fixed cameras to bare D435i mesh; fix two resulting bugs
    Per instruction: the two frame-mounted cameras' mesh
    (d435_with_cam_stand.stl, via xarm_description's d435i_urdf) carries
    xarm's own arm-mount stand baked in, correct for the wrist camera but
    wrong here where these two have their own separate STEP-modeled
    mounting bracket. Switched to ros-humble-realsense2-description's
    sensor_d435i macro instead, which uses the bare d435.dae mesh (no
    mount) and is the same macro most ROS RealSense integrations use;
    wrist camera is untouched (its stand mesh is correct there).
    Two bugs surfaced by the switch, both fixed:
    1. gz-sim doesn't resolve 'package://' mesh URIs against
    AMENT_PREFIX_PAT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
    [ranger_xarm6.urdf.xacro]
2026-09-22 Mount the two fixed D435i cameras at camera_module_for_design's centre height, with a real position offset
    Height (Z) raised from the individual Realsense_Camera_module STEP
    node's own position (0.06312m) to Camera_module_for_design's own
    bbox-center height (0.3885m in base_link frame), computed the same way
    as extras_link's own bbox-center placement but scoped to just that
    STEP node (excludes COMPOUND004, the separate root-level leftover
    bucket folded into extras_link).
    Also gives the two cameras a real Y-position offset (+-0.034949m)
    instead of the coincident placement they had before: in STEP the two
    Realsense_Camera_module variants actually sit at the exact same point
    (differing only by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
    [ranger_xarm6.urdf.xacro]
2026-09-22 Tune fixed camera positions per visual check in Gazebo
    fixed_cam1_xyz/fixed_cam2_xyz adjusted from the symmetric-Y-offset
    starting point (matching the USB camera pair's spacing) to an
    asymmetric X/Y placement, same provisional workflow as the other
    STEP-derived transforms in this file.
    [ranger_xarm6.urdf.xacro]
2026-09-23 Wire realsense2_camera for the two fixed D435i cameras, sim and real
    - Bridge fixed_cam1/fixed_cam2's gz-sim sensor topics to ROS2 (color/
    infra1/infra2/depth+points), and launch the real realsense2_camera
    driver per camera for sim:=false, both landing on matching
    /{robot_id}/fixed_cam{1,2}_camera/... topics.
    - Fix the depth sensor's optical_frame_id: gz-sim's rgbd_camera
    publishes point-cloud XYZ in the physical (non-optical) frame
    convention, not the rotated optical one its own SDF element name
    implies; verified empirically against tested_world.world's geometry
    and a row/column sweep for mirror flips.
    - Share one RViz instance (point-cloud/image displays) as the digital-
    tw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
    [ranger_xarm6.urdf.xacro]
2026-09-23 Bridge real 2D depth view for fixed_cam1/2; fix black depth Image display
    - gz-sim's rgbd_camera sensor publishes two distinct image topics under
    '.../depth/': 'image' (an rgb8 preview render, already bridged, not
    metric depth despite the name) and 'depth_image' (the actual 32FC1
    depth buffer the point cloud is generated from, not previously
    bridged). Add the latter so there's a real 2D depth map to view.
    - RViz's Image display was rendering fixed_cam2's depth view solid
    black: its auto min/max normalization scans the buffer, and gz-sim
    fills out-of-range rays with IEEE +inf (43% of fixed_cam2's pixels,
    which mostly faces open background) -- a single +inf collapses the
    scanne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
2026-09-23 Add two SincereFirst USB cameras (left_camera/right_camera), full pipeline
    Position (0.142, +-0.034949, 0.378500) reconstructs the real STEP-measured
    USB-camera-pair spacing that fixed_cam1_xyz/fixed_cam2_xyz originally
    placeholder-borrowed before their own visual tuning moved them elsewhere
    (see git history on those properties); Z matches the D435i's current
    post-tuning height. left/right assigned via REP103 (forward=X, left=+Y),
    using fixed_cam1 (rpy=0) as the "front" reference.
    - ranger_xarm6.urdf.xacro: usb_camera_macro (link + REP103 optical frame,
    placeholder box geometry -- no SincereFirst mesh available) and
    usb_camera_sensor_tags (gz camera sensor, mirroring fixed_cam_sensor_ta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
    [ranger_xarm6.urdf.xacro]
2026-09-23 Point left_camera/right_camera sideways, not forward
    Split the shared usb_camera_rpy into left_camera_rpy/right_camera_rpy
    (yaw +-pi/2): they're meant to look sideways per instruction, not forward
    like fixed_cam1 -- the previous rpy="0 0 0" default was an unstated
    assumption, not a given requirement. Verified live via TF: left_camera's
    local forward (+X) axis now maps to world +Y (left), right_camera's to -Y
    (right).
    [ranger_xarm6.urdf.xacro]
2026-09-23 Roll left_camera/right_camera's mesh so its long edge sits front-rear
    Adds a +pi/2 roll about the link's own local X (its view direction) to
    ONLY the box's <visual>/<collision> <origin>, per instruction -- the mount
    joint and ${name}_optical_joint (and therefore the actual view direction
    and TF) are untouched, since a link's visual/collision origin is a purely
    local offset for the shape, independent of the link's own frame.
    Before this, the box's short edge (Y=0.020) landed on the front-rear axis
    and a long edge (Z=0.030) on vertical, since each camera's mount joint is
    a pure yaw and un-rolled local Y maps to world-front-rear while local Z
    stays world-up. After the roll they swap: long edge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
    [ranger_xarm6.urdf.xacro]
2026-09-23 Retune left_camera/right_camera Y/Z placement
    Manual adjustment: Y from +-0.034949 to +-0.059898, Z from 0.378500 to
    0.390000.
    [ranger_xarm6.urdf.xacro]
2026-09-23 Wire the wrist Orbbec Gemini 2, sim and real, mesh unchanged
    Mesh stays the existing D435i+stand placeholder (xarm_device's
    add_realsense_d435i, untouched) -- no combined Gemini2+xArm-mount mesh
    exists to swap in (orbbec_description only ships a bare camera body, same
    situation realsense2_description is in for the two fixed cameras). Software
    side wired the same way as fixed_cam1/fixed_cam2, applied to the wrist's
    existing D435i frame chain (camera_link/camera_depth_frame/camera_color_frame/
    camera_left_ir_frame/camera_right_ir_frame, from xarm_device_macro, xarm_ros2
    submodule, unchanged).
    - ranger_xarm6.urdf.xacro: new wrist_camera_sensor_tags macro, same
    optical_frame_id fix as fixed_c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
    [ranger_xarm6.urdf.xacro]
2026-09-23 Default all sensor displays off in RViz, viewer picks what to look at
    Every camera-related display (both fixed D435i's point clouds/color/depth
    images, both USB cameras, the wrist Gemini 2's point cloud/color image)
    now starts Enabled: false, per instruction -- nothing sensor-related
    renders (or costs render time) until the viewer checks it in the Displays
    panel. Grid/TF/RobotModel/Marker/Path are unaffected, still on by default
    (not sensor displays).
2026-09-23 Stop base_pose_publisher's entity-wait from flooding gz-sim's error log
    _wait_for_entity() previously blocked __init__ with a fixed 15s timeout
    before ever publishing TF, then gave up and let the periodic gz-teleport
    thread start hammering set_pose against a still-nonexistent entity if
    Gazebo hadn't finished spawning by then -- each rejected call makes
    Gazebo's own UserCommands plugin log an unsuppressible server-side
    "[Err] Unable to update the pose for entity id:[0]" line. This repo now
    spawns noticeably more sensors than when that timeout was chosen (two
    fixed D435i's, two USB cameras, the wrist Gemini2), and a sufficiently
    slow-starting Gazebo (confirmed possible: this session hit a case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
2026-09-23 Add fixed_cam_use_mesh toggle, default off, to test mesh self-occlusion
    New xacro:arg wired to sensor_d435i's own 'use_mesh' param for both
    fixed_cam1 and fixed_cam2 (default false per instruction), so the DAE
    mesh can be swapped for its small box fallback to check whether the mesh
    itself was obstructing/producing wrong-looking point cloud data.
    Tested both ways and it isn't: fixed_cam1's wall/floor geometry and
    fixed_cam2's arm-proximity close-range returns are essentially unchanged
    mesh-on vs mesh-off. If anything mesh-off is slightly worse -- the box
    fallback's default origin sits centered on the sensor's own origin (front
    half poking just past the near clip), unlike the DAE mesh, which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
    [ranger_xarm6.urdf.xacro]
2026-09-23 Revert "Add fixed_cam_use_mesh toggle, default off, to test mesh self-occlusion"
    This reverts commit f497de02af3bf0830eaebacf38162350eef41352.
    Testing (self-occlusion by the D435i mesh, ruled out empirically -- see
    that commit's own message) is finished; meshes back per instruction.
    [ranger_xarm6.urdf.xacro]
2026-09-23 Use real Orbbec Gemini 2 extrinsics for the wrist camera, mesh unchanged
    Per instruction: mesh stays the D435i+stand placeholder (camera_link,
    unchanged, still parented to link_eef via xarm_device's own
    camera_link_joint), but the depth/color/left_ir/right_ir spacing these
    frames encode now reflects the real Gemini 2, not xarm_description's
    borrowed D435i numbers.
    New orbbec_gemini2_extrinsics macro adds gemini_depth_frame/
    gemini_color_frame/gemini_left_ir_frame/gemini_right_ir_frame (+ their
    optical children) parented directly to camera_link, with joint origins
    pulled verbatim from ros-humble-orbbec-description's gemini_2.urdf.xacro
    (installed on this machine, real measured values, not pl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
    [ranger_xarm6.urdf.xacro]
2026-09-23 Add HiPNUC HI14R3-232-000 9-axis IMU, sim gz sensor + frame_id fixup
    Mounts a placeholder box (real HI14 M12-variant datasheet dimensions,
    40x58.5x20mm) on top of extras_link: hipnuc_imu_link (mount frame,
    identity-aligned to base_link/REP103) with hipnuc_imu_data_frame as its
    child carrying the sensor's real Right-Forward-Up native axis convention
    (datasheet Figure 30), reconciled to REP103 with a -90deg yaw.
    gz-sim's imu sensor type has no optical_frame_id-style override (unlike
    the camera sensors already in this file), so it always publishes an
    unresolvable auto-generated scoped entity path as header.frame_id.
    Verified this empirically and worked around it the standard way: bridge
    to a "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
    [ranger_xarm6.urdf.xacro]
2026-09-23 Add RViz Imu display for the HiPNUC IMU, off by default
    Same convention as every other sensor display in this config: unchecked
    until the viewer picks it. Subscribes to hipnuc_imu/data, which already
    carries the corrected frame_id from scripts/fix_imu_frame_id.py.
2026-09-23 Register HiPNUC IMU as a ros2_control state interface
    Silences 1 of 3 "IMU sensor '...' not found in hardware_info, skipping."
    warnings from gz_ros2_control's GazeboSimSystem: it scans every IMU
    sensor entity in the whole simulated world for each of the URDF's three
    separate <ros2_control> hardware components (arm, gripper, RangerBaseState),
    independent of ros_gz_bridge/fix_imu_frame_id.py's own topic pipeline
    (unaffected either way, verified live again after this change). Added
    the sensor's state_interface entries to RangerBaseState, the ranger_xarm6-
    owned block, since it's a base-mounted accessory. The remaining 2
    warnings come from the arm's/gripper's own <ros2_control> blocks, which
    are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
    [ranger_xarm6.urdf.xacro]
2026-09-23 Simplify IMU frame_id fix: use <gz_frame_id> instead of a republisher node
    While researching a Livox Mid-360 reference macro (uses <gz_frame_id> on
    its gpu_lidar sensor), found that libgz-sensors8's core Sensor class has
    a generic FrameId()/SetFrameId() mechanism driven by a <gz_frame_id> SDF
    tag, and both the imu and lidar sensor plugins read it via that same base
    class when filling their message headers. Verified live: adding
    <gz_frame_id> to hipnuc_imu_sensor makes gz-sim publish the correct,
    TF-resolvable frame_id directly, no republisher needed -- the earlier
    conclusion that IMU sensors have no frame_id override at all was wrong
    (checked imu.sdf's schema and libgz-sensors8-imu.so specif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
    [ranger_xarm6.urdf.xacro]
2026-09-23 Add Livox Mid-360 3D LIDAR: mesh, gz sensor, sim/real bridge, RViz
    Mounted on extras_link, 30mm above the HiPNUC IMU's own joint position
    (same X/Y, Z+0.030). Real mesh (not a placeholder box): copied from a
    sibling workspace's robotnik_sensors package, which Robotnik ships in
    production for the same Mid-360 unit; this repo can't depend on a
    package from an unrelated workspace so it's vendored here as its own
    copy. Mount/native-origin frame split and real mesh-alignment offsets
    (90deg visual roll, +36.5mm sensor origin) also come from Robotnik's own
    sensor_livox_mid_360 macro. The data frame is named "livox_frame"
    (unprefixed-matching), not "livox_mid360_frame", to line up with Weston
    Robot'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
    [livox_mid_360.stl, ranger_xarm6.urdf.xacro]
2026-09-23 Update Livox Mid-360 mount pose, document the new hand-tuned values
    livox_mid360_xyz: "0 0.04 0.2505" -> "0 0.04 0.2805" (another 0.030m up
    from the nominal "30mm above the IMU joint" position).
    livox_mid360_rpy: "0 0 1.570796" -> "0 0 -1.570796" -- livox_mid360_link
    no longer cancels extras_rpy's own -90deg yaw, so it's now 180deg
    rotated in yaw relative to base_link rather than identity-aligned (still
    fine functionally: the Mid-360 scans the full 360deg horizontally
    either way, only the raw scan's angle-to-robot-front mapping shifts).
    Updated the placement/rotation derivation comments to describe the
    actual current values instead of the stale nominal ones. Verified live:
    extras_link->livo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
    [ranger_xarm6.urdf.xacro]
2026-09-23 Add F/T sensor accessory cylinder between arm flange and camera mount
    Cylinder (diameter=126mm, height=95mm, height along the flange/local-Z
    direction) inserted between link6's own flange and the wrist camera
    mount, pushing the camera and gripper 95mm further out accordingly, per
    instruction. No real F/T sensor mesh exists anywhere UFACTORY publishes
    it (confirmed earlier this session); this is a placeholder cylinder,
    same treatment as the HiPNUC IMU's own placeholder box.
    xarm_device_macro.xacro's own joint_eef (link6 -> link_eef) hardcodes a
    0 0 0 origin with no override parameter, so link_eef itself can't be
    pushed further from link6 without editing the xarm_ros2 submodule.
    Instead: add_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
    [ranger_xarm6.urdf.xacro]
2026-09-23 Resize F/T sensor cylinder to match the real flange radius, rebuild
    radius=63mm/length=95mm -> radius=36.5mm/length=55mm. The new radius
    exactly matches end_tool_1300.stl's own measured flange-face radius
    (parsed directly from the mesh: every front-face edge vertex sits at
    r=36.500mm), so the cylinder now sits flush with the real flange
    instead of overhanging it.
    Updated the dependent offsets accordingly: ft_sensor_joint and
    camera_mount_joint both halve the cylinder's own length for their Z
    placement (0.0475 -> 0.0275, half of the new 0.055m), and placeholder
    mass/inertia scaled down by volume ratio (~0.194x) to keep the same
    implied density.
    Verified live: TF confirms both offsets at exa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
    [ranger_xarm6.urdf.xacro]
2026-09-23 Remove fixed_cam1's sim-only depth-test target cylinder
    That cylinder (0.5m in front of fixed_cam1, gated _is_gz_sim) was a
    debug aid for verifying the fixed cameras' point-cloud frame/convention
    fix earlier this session; no longer needed now that fix is confirmed
    working, and not referenced anywhere else (RViz, launch.py).
    Verified live: no "test_target" left in the expanded URDF, xacro
    expands cleanly, sim launches with no new errors.
    [ranger_xarm6.urdf.xacro]
2026-09-23 Fix F/T sensor's frame_id; document why it can't sit at the cylinder
    Answering "is the F/T sensor at the centre of the cylinder": no, and it
    can't be, empirically -- tried moving force_torque_sensor from joint6 to
    ft_sensor_joint (the fixed joint whose origin coincides with the F/T
    cylinder's own centre) and verified live that gz-sim's force_torque
    sensor does not work on a fixed joint: the gz topic gets advertised but
    never publishes a single message, no error either (likely gz-physics'
    own fixed-joint-chain reduction merging link_eef through camera_link
    into link6's rigid body internally, leaving no separate constraint at
    ft_sensor_joint to measure). Reverted to joint6, the nearest actual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
    [ranger_xarm6.urdf.xacro]
2026-09-23 Finish all the sensors and meshes integration, pending callibration and testing
2026-09-24 Replace F/T sensor cylinder with the real AI1302 mesh, add ft_sensor_frame
    Mesh: step/ft_sensor_AI1302_20240411.STEP (vendor STEP: RFT60-HA01 plus
    its xArm 1200/1300 universal adapter and tool-side plate) converted by
    step/convert_ft_sensor.py via OpenCascade (OCP), not FreeCAD. Re-framed
    so the origin is the adapter's seating face on the sensor axis (flush
    with link6's flange), +Z toward the tool, 58.6mm tall, and yawed 90deg
    so the adapter's dowel pin lands in end_tool_1300.stl's dowel hole at
    (0, -25mm). Collision is the convex hull above the seating face only.
    Mass 0.445kg per the UFACTORY F/T sensor manual V2.2.0; COM/inertia from
    the STEP geometry scaled to that mass.
    ft_sensor_joint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
    [ft_sensor_AI1302_20240411.STEP, ft_sensor_ai1302.stl, ft_sensor_ai1302_collision.stl, ranger_xarm6.urdf.xacro]
2026-09-24 Add arm_trajectory_controller (loaded inactive) for MoveIt execution
    JointTrajectoryController over the same six arm joints as
    arm_velocity_controller, position command interface. Spawned --inactive so
    wbc.py's velocity controller still owns the arm by default; only one of
    the two may be active at a time. Verified in sim: switch succeeds and a
    FollowJointTrajectory goal reaches its target.
    [ros2_controllers.yaml]
2026-09-24 Fix sim spawn height, add arm trajectory goal tolerances
    Spawn/hold z default 0.15 -> 0.315: base_link's height above the floor
    with the wheels on the ground (ranger_mini_v3's wheel collision
    cylinders bottom out 0.315m below base_link; visuals 0.321m).
    base_pose_publisher.py holds the entity at this z every tick, so 0.15 sat
    the robot ~16.5cm into the floor, which also put the floor 16.5cm too
    close for sensors and the arm.
    arm_trajectory_controller: 0.02 rad per-joint goal tolerance. Without it
    the controller reported success when the arm never reached its target
    (seen in sim: blocked by the floor, ended 8-20mm off), and MoveIt passed
    that on. _prefix_controller_joints now also prefixes p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
    [ros2_controllers.yaml]
2026-09-24 Add MoveIt 2 config and sequential mobile manipulation
    ranger_xarm6_moveit_config: SRDF (planar virtual joint odom->base_link,
    groups arm/gripper/base, named states home/stow), KDL kinematics, joint
    limits (0.3 default scaling), OMPL, controllers, move_group launch with
    RViz MotionPlanning. Collision matrix generated from the URDF by
    scripts/generate_collision_matrix.py (adjacent + rigid pairs + reviewed
    overrides) rather than the Setup Assistant; scripts/sample_self_collisions.py
    checks it against a live move_group. stow picked by grid search, verified
    collision-free with +-0.05 rad margin on every joint.
    ranger_xarm6_manipulation: MoveToGoal action. SEQUENTIAL mode: arm to a
    transit state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
    [_disable_collisions.srdf.xacro, joint_limits.yaml, ranger_xarm6.srdf.xacro]
2026-09-24 Add artc_lab.world pick-and-place room and a world launch arg
    artc_lab.world, generated by worlds/generate_artc_lab.py from
    world_plan_view.png scaled to a 10m x 5.2m room: 2m walls, four 0.75m
    tables with ten 5cm cubes near their aisle-side edges, a cupboard and a
    plant. The drawing's red area is left empty for runtime obstacles (not
    part of the map). Origin at the room's bottom-left corner as drawn;
    robot home is x:=0.94 y:=4.35 yaw:=-1.5708.
    ranger_xarm6.launch.py: new 'world' arg (default tested_world.world,
    unchanged). base_pose_publisher.py now gets the world's own SDF name for
    its set_pose teleports, and tested_world's max_x wall clamp only applies
    in tested_world.
    Verified: robot s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
2026-09-24 Add Livox/IMU mount bracket and real HiPNUC IMU mesh
    - New livox_imu_mount_link (livox_imu_mount.stl) sitting flush on
    extras_link, carrying the IMU under its top deck and the Livox on top.
    - hipnuc_imu_link: placeholder box replaced by hipnuc_imu.stl, placed
    from the shared CAD frame of the two new meshes.
    - livox_mid360_link re-parented onto the mount, centered on its deck
    hole pattern (same X/Y as before, ~4mm lower).
    - Regenerate the MoveIt collision matrix for the new link.
    [_disable_collisions.srdf.xacro, hipnuc_imu.stl, livox_imu_mount.stl, ranger_xarm6.urdf.xacro]
2026-09-24 Replace full-detail mesh colliders with CoACD convex decompositions
    extras, mount plate, Livox/IMU mount, HiPNUC IMU and Livox Mid-360 used
    their visual meshes as colliders (~157k tris total, 122k for extras
    alone). scripts/generate_colliders.py now decomposes each with CoACD
    into convex hulls (108 hulls, ~18.7k tris), one <collision> per hull
    via generated robots/_colliders.xacro macros, so MoveIt/Gazebo treat
    them as convex pieces. All visual surfaces stay within 0.5mm of the
    hulls.
    [_colliders.xacro, extras_compressed_00.stl, extras_compressed_01.stl, extras_compressed_02.stl, extras_compressed_03.stl, extras_compressed_04.stl, extras_compressed_05.stl, extras_compressed_06.stl]
2026-09-24 Default to an empty world and mirror world models into RViz
    - worlds/empty.world (ground plane only) is now the default 'world'
    arg; tested_world.world and artc_lab.world stay selectable.
    - scripts/world_markers.py publishes the loaded world's models as a
    MarkerArray in the odom frame, following non-static models (e.g.
    artc_lab's cubes) live from gz-sim; shown by a new RViz display.
    - Fix the launch docstring's artc_lab example losing its line break.
2026-09-24 Use Fuel cabinet/plant models and a room-sized floor in artc_lab
    - The cupboard is now Gazebo Fuel's OpenRobotics/Cabinet (CC0): its
    open 2cm-plate wooden shelf rebuilt at the drawing's footprint, open
    side facing into the room.
    - The plant's foliage is Fuel's slhdn/plant mesh (CC-BY 4.0, Alireza
    Ahmadi), copied to meshes/big_plant.stl, scaled up on the pot.
    - The ground plane's visual is sized to the room (10.2 x 5.4m) instead
    of 30 x 30m; the collision plane stays infinite.
    - world_markers.py draws room-sized ground planes as a floor slab just
    under RViz's grid (planes over 50m, e.g. empty.world's, still skipped).
    - The RViz grid is 20 x 20 cells so it covers the whole room.
    Co-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
    [big_plant.stl]
2026-09-24 Add sequential and whole-body MoveIt control for the Ranger + xArm6
    The base only crabs (fixed heading) or spins in place, never both, to
    match the Ranger's steering modes.
    - moveit_config: MoveIt's URDF models the base as base_x/y/theta joints
    (plus a never-planned base_z) instead of a planar virtual joint, fed
    from odom -> base_link TF by base_joint_state_publisher.py. Groups
    base_translation, base_rotation and whole_body (x, y + arm); base
    joint limits; base_trajectory_controller in moveit_controllers.
    - manipulation: control.launch.py (controller:=moveit_sequential |
    moveit_whole_body, declared choices) replaces manipulation.launch.py.
    MoveToGoal modes are DEFAULT=0, SEQUENT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
    [joint_limits.yaml, ranger_xarm6.srdf.xacro, ranger_xarm6_moveit.urdf.xacro]
2026-09-25 Damp the Ranger's passive wheels and drive the gripper fingers in sim
    - ranger_mini_v3: damping and friction on the 4 steering and 4 wheel
    joints. Nothing drives them (the base is teleported), so while
    parked the steering joints swung at ~1 rad/s and the wheels rolled.
    Sim only; the base's motion is unchanged.
    - ranger_xarm6: in Gazebo, the five finger/knuckle joints join
    drive_joint's ros2_control block as gz_ros2_control mimic joints.
    xarm_gripper_macro's Gazebo Classic mimic plugin never loads in
    gz-sim, and gz-sim's own mimic constraint needs bullet-featherstone,
    so only the outer knuckle moved. The macro's parts are now called
    one by one; real hardware still gets no grip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
    [ranger_mini_v3.xacro, ranger_xarm6.urdf.xacro]
2026-09-25 Simulate the Mid-360's built-in IMU and the Ranger's wheel odometry
    Both publish what the real drivers publish, so fusion can be built and
    tested in sim against the same topics.
    - Mid-360 IMU: livox_imu_frame at the ICM-40609's position in the point
    cloud frame (11.0, 23.29, -44.12 mm, manual), a 200 Hz gz IMU with
    datasheet white noise, and gz_livox_imu.py publishing 'livox/imu' in
    livox_ros_driver2's format: acceleration in g, frame_id the literal
    "livox_frame". The teleported base gives Gazebo's IMUs no motion to
    sense (a 0.3 rad/s spin read 0.006 rad/s), so the node adds the base's
    angular velocity and the acceleration at the IMU's position from
    ground truth.
    - Wheel odome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
    [ranger_xarm6.urdf.xacro]
2026-09-25 Add ranger_xarm6_navigation with an EKF for odom -> base_link
    First piece of the mapping/navigation package: robot_localization's EKF
    over the Ranger's wheel odometry and the Mid-360's built-in IMU.
    - odometry.launch.py: ekf_inputs.py + ekf_node in the robot's namespace,
    publishing odometry/filtered and odom -> base_link. x/y/yaw set the
    initial state (the spawn pose in sim, where odom is Gazebo's world).
    - ekf_inputs.py makes the raw driver messages fusable: Livox IMU
    acceleration g -> m/s^2, its unprefixed "livox_frame" -> the chip's
    frame, real covariances instead of all-zero ones (which
    robot_localization treats as near-certain), a zero-velocity gyro bias
    estimate while the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
2026-09-25 Compute the sim Mid-360 IMU from ground truth, not a Gazebo sensor
    The base is kinematic (teleported), so the Gazebo chassis's own physics
    motion isn't the robot's: between teleports it creeps on its passive
    wheels, and the teleport that snaps it back carries no velocity. The
    Gazebo IMU sensed only the creep, a one-sided rotation (-0.012 rad/s
    during a straight crab, truth 0) that turned the EKF's heading 2.6 deg
    in 6 s.
    sim_livox_imu.py (replacing gz_livox_imu.py) computes the IMU from
    ground_truth/odom at 200 Hz sim time: angular velocity, gravity's
    reaction plus the acceleration at the IMU's position, rotated into
    livox_imu_frame, with the same datasheet white noise and seeded turn-on
    bi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
    [ranger_xarm6.urdf.xacro]
2026-09-25 Add FAST-LIO2 mapping on the Mid-360 and its built-in IMU
    - FAST_LIO: hku-mars/FAST_LIO ROS2 branch as a submodule.
    - mapping.launch.py: livox_cloud_to_custom + fastlio_mapping in the
    robot's namespace, outputs remapped under fast_lio/; map_save writes
    the 3D map to the 'map' argument (.pcd).
    - livox_cloud_to_custom (C++): the driver's xfer_format 0 PointCloud2
    (per-point absolute timestamps) -> the Livox CustomMsg FAST-LIO reads,
    so livox/lidar stays a PointCloud2 for RViz and Nav2, on hardware as
    in sim. A scan whose points share one time (gz-sim renders at an
    instant) is stamped so FAST-LIO puts its end at the capture time.
    - fast_lio.yaml: extrinsic from the Livox manual (not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
2026-09-25 Document ranger_xarm6_navigation and the new dependencies
    - README: MoveIt/manipulation/navigation packages and the FAST_LIO
    submodule in Contents, robot_localization + pcl_ros in the install
    steps, a navigation quick start (EKF odometry, FAST-LIO mapping).
    - ranger_xarm6_navigation/README.md: sensors used and why, the EKF and
    its input fixes, the mapping session, and the sim map evaluation
    (accuracy, coverage by height, the lidar-height limits).
2026-09-27 Render sim cameras only on demand; D435i depth as Nav2 gets it
    The camera bridges subscribed to every stream of every camera, so
    Gazebo rendered them all all the time (RTF ~0.05 with the fixed cameras
    on). They are now lazy, through a config_file: this parameter_bridge
    ignores 'lazy' for topics given on the command line. RTF ~0.85 with all
    cameras enabled.
    The fixed cameras' sim depth matches what Nav2 uses from the real
    D435i: 424x240 at 15 Hz, 87 deg, nothing closer than 0.28 m, ~1 cm
    noise. The real driver runs depth at 848x480/15 Hz, decimated 2x.
    Claude-Session: https://claude.ai/code/session_01Djjhv63cjaQ1RiaHeYyGom
    [ranger_xarm6.urdf.xacro]
2026-09-27 EKF: odom -> base_footprint, base_link keeps its height
    In 2D mode the EKF put base_link at z 0 in odom, 0.315 m below the sim's
    ground truth: Nav2 measures obstacle heights in odom, MoveIt places the
    world in it. The EKF now estimates base_footprint and a static
    transform lifts base_link by base_height.
    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
2026-09-27 Add Nav2 with the front D435i, depth in the map, and a collision monitor
    - pcd_to_grid.py: FAST-LIO .pcd (+ the depth camera's low obstacles)
    -> map_server grid.
    - navigation.launch.py / nav2.yaml: NavFn, RotationShim + Regulated Pure
    Pursuit, voxel costmaps on the Mid-360 and the front D435i, velocity
    smoother, collision monitor; static map -> odom until a localizer.
    - depth_to_cloud: depth image -> 5 cm voxels within 3 m, released only
    once TF can place it (a cloud ahead of TF froze the costmap's TF).
    - depth_mapper.py: the front camera's low obstacles during mapping
    (<map>_depth.pcd), heights cut against the floor under the robot.
    - collision_monitor with stop/slowdown zones and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
2026-09-27 Collision monitor: approach only; obstacle memory in the costmaps too
    Found with random obstacles in sim:
    - stop and slowdown zones act on every command in this Nav2: a stop zone
    kept the base from backing away from what stopped it, a slowdown zone
    held turns at ~0.05 rad/s until Nav2 gave up beside a box. Approach
    (direction-aware) is the only zone now.
    - Nav2's recoveries clear the costmaps, and a low box already below the
    camera's view was then forgotten and planned through. obstacle_memory
    is now also a marking source in both costmaps.
    - the memory forgot that box after its max age while the base was still
    beside it: near the robot (1 m) it no longer ages out, and the
    footp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
2026-09-27 Show runtime-spawned models in RViz; README quick start covers mapping
    world_markers.py drew only the world file's models, so
    spawn_obstacles.py's boxes were invisible in RViz. It now asks gz-sim's
    scene/info every 2 s for models the SDF doesn't have (the robot
    excepted) and adds or deletes their box/cylinder/sphere markers. Nav2's
    RViz shows the world markers too.
    The README's quick start is one path: build, the sim (with random
    obstacles), mapping, the 2D grid, navigation, the real robot.
    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
2026-09-27 README usage guide: robot, mapping, navigation, MoveIt, gripper
    The repo README now walks through the whole thing, each command run in
    sim: starting the robot (random obstacles), mapping (its own section),
    the 2D grid, Nav2 goals, MoveIt sequential and whole-body goals (named
    poses, new poses in odom or base_link, orientations, base chosen or
    given, RViz), saving a new named pose, and the gripper; plus
    troubleshooting. The navigation README points there.
    Two helpers in ranger_xarm6_manipulation:
    - gripper.py open|close|<rad>: waits for the controller (a bare
    `ros2 topic pub --once` was sometimes lost; the controller subscribes
    best-effort), sends, reports where the fingers stopped.
    - ar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
2026-09-27 Gripper action server; route MoveIt's base motion through the collision monitor
    - gripper_action_server.py: control_msgs/GripperCommand on
    gripper_command (drive_joint rad, 0 open .. 0.85 closed; stalled =
    holding something), for callers that need a result.
    - base_trajectory_server.py: while ranger_xarm6_navigation's collision
    monitor runs (another node subscribes to cmd_vel_smoothed), send
    there instead of cmd_vel, so MoveIt's base moves are guarded by what
    the sensors see too; parameter collision_monitor auto/never/always.
    Waits until Nav2's velocity smoother has gone quiet (its ramp to zero
    interleaved with a spin right after a Nav2 goal, in sim).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
    [base_trajectory_server.yaml]
2026-09-27 Add ranger_xarm6_tasks: behavior-tree tasks, edited in Groot2
    - task_server (BehaviorTree.ROS2's TreeExecutionServer): runs a tree by
    name on /robot_a/execute_task, re-reading trees/ and config/ from the
    source folder per task, one task at a time; writes the Groot2 project
    (trees + node models) at startup; Groot2 live view on port 1667.
    - Nodes over existing actions: NavigateToWaypoint/NavigateToPose (Nav2),
    BaseToPose, TurnBase (back_towards/yaw/angle), ArmToNamedPose,
    ArmToPose, WholeBodyToPose (MoveToGoal), Gripper (holding check), Say.
    Own action-client base (action_node.hpp): BehaviorTree.ROS2's
    RosActionNode lost Nav2's goal replies after a MoveIt goal on Humble.
    MoveIt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
2026-09-28 ranger_xarm6_tasks: watch tasks live in klein-bt, edit them in Groot2
    Groot2's free monitor stops at 20 nodes (DemoPickPlace is over that), so
    the live view moves to klein-bt (MIT, browser dashboard, speaks the Groot2
    monitor protocol BT.CPP already serves on port 1667; no code change).
    Groot2 stays the editor.
    README: klein-bt install and a "Watch a task live" section (tested in sim
    against the task server: connects per task, live status and blackboard,
    switches trees between runs); a step-by-step Groot2 editing guide (change a
    task, create one, reuse PickAt/PlaceAt, check git diff after saving); the
    task layer only starts servers; same RMW_IMPLEMENTATION in the run_task
    terminal. tasks.la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
2026-09-28 Sim base driven by its wheels through gz_ros2_control
    The sim base was teleported along cmd_vel (base_pose_publisher.py): no
    slip, no inertia, through walls, and nothing it carried came along. Now
    (base_drive:=physics, the default) gz_ros2_control drives the 4 steering
    joints (position) and 4 wheels (velocity), and ranger_sim_base.py stands
    in for the real driver:
    - cmd_vel -> wheels with the real driver's motion modes
    (westonrobot_ranger_ros2 TwistCmdCallback): crab when linear.y != 0,
    spin in place under a 0.476 m turn radius (vx ignored), dual Ackermann
    otherwise; wheel positions from TF (rear-right isn't symmetric).
    Wheels change speed at most 1 m/s^2; a big re-steer (> 0.5 rad,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
    [ranger_mini_v3.xacro, ranger_xarm6.urdf.xacro, ros2_controllers.yaml]
2026-09-28 Localization: NDT scan-to-map against the FAST-LIO map (map -> odom)
    navigation.launch.py localization:=ndt runs lidar_localization_ros2
    (submodule, with ndt_omp_ros2 humble) on the Mid-360 cloud without the
    arm, against the FAST-LIO map moved into the map frame, and publishes
    map -> odom on top of the EKF's odom -> base_link, like AMCL.
    initial_pose:="x y yaw_deg", else RViz's 2D Pose Estimate. Only its NDT
    core (odom-TF prediction; no IMU preintegration, smoother or deskew). Its
    'map' topic (a PointCloud2) is remapped off map_server's grid; it never
    starts Nav2's bond, so it has its own lifecycle manager with the bond off.
    localization:=static (identity map -> odom) stays the default.
    scr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
2026-09-28 Room in the map frame: arm poses, MoveIt's world, markers; planar map -> odom
    With the EKF + NDT, odom drifts from the room, so what's placed in the
    room now lives in map:
    - task layer: arm poses default to (and the examples are in) robot_a_map;
    goals are resolved to odom through TF when they start, like waypoints.
    - sim: world_collision_objects.py / world_markers.py keep the world file's
    models in map and send them in odom through the current map -> odom
    (map_to_odom.py: smoothed over 5 s, resent past 2 cm / 0.6 deg; NDT
    jitters ~2 cm, and resending the tables at every jitter invalidated a
    docking plan mid-motion). No map frame (no Nav2): identity.
    Localizer fixes found by runnin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
2026-09-28 ranger_xarm6_bringup: the whole sim stack in one launch, in Foxglove
    sim.launch.py replaces the four terminals (robot, Nav2, MoveIt, tasks) and
    their RViz windows. Each stage starts when the one before is ready
    (scripts/wait_for.py: controllers active -> Nav2 [+ EKF and NDT with
    localization:=ndt] -> bt_navigator active -> MoveIt -> move_to_goal up ->
    tasks), not after fixed delays. Also starts foxglove_bridge (8765) and
    opens the Foxglove app on it, klein-bt on the task server's live view
    (groot2_port passed to both), and the obstacle buttons' server.
    config/foxglove_layout.json (import once): 3D view following the robot
    (robot model, map, costmaps, footprint, plan, room, lidar, NDT pose;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
2026-09-28 READMEs: screenshots
    Screenshots in screenshots/ (world_plan_view.png moved there from the
    repo root; the code's references to it follow): the hero GIF, gripper,
    Foxglove layout and obstacle buttons, Groot2, klein-bt, the 3D map and
    2D grid, Nav2 around obstacles. A placeholder comment marks the one not
    taken yet (manipulation: sequential vs whole-body GIFs).
    Claude-Session: https://claude.ai/code/session_01J4zo453gEdwitfs3w5jzWy
2026-10-01 F/T sensor frame at the sensor's tool-side end; real-hardware republisher
    UFACTORY support confirmed the sensor's reference frame is at the end of
    the sensor, not the middle. ft_sensor_frame moves from 28.25mm (centre
    of the sensing body) to 58.6mm (tool-side mounting face) above the
    seating face; the sim's torque shift (ft_sensor_frame_z) follows.
    Real hardware: xarm_api's uf_ftsensor_ext_states now goes through
    fix_wrench_frame_id.py too (offset 0), swapping its non-TF frame_id
    for ft_sensor_frame so it resolves via TF like the sim's.
    [ranger_xarm6.urdf.xacro]
